jschmidtcr/manoRobot/archivos de mano 3D/README

Archivos obtenidos de http://www.inmoov.fr/download/
