jschmidtcr/manoRobot/archivos de mano 3D/Hand_robot__InMoov/WristlargeV4.stl

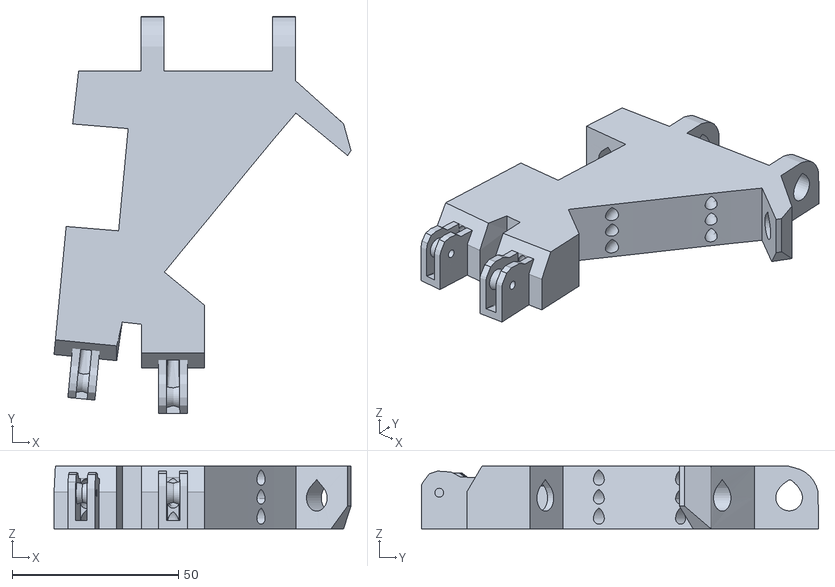
[picture p10: CAD file, 2014-05-28]
archivos de mano 3D/Hand_robot__InMoov/WristlargeV4.stl
89.2 x 119.4 x 18.9
