jschmidtcr/manoRobot/archivos de mano 3D/Inmoov_Robot_Rotation_Wrist/rotawrist2.stl

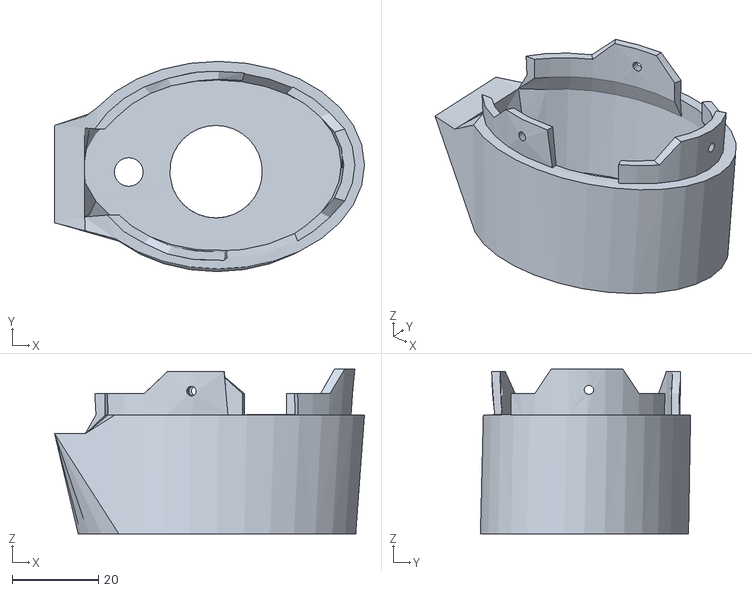
[picture p11: CAD file, 2014-05-28]
archivos de mano 3D/Inmoov_Robot_Rotation_Wrist/rotawrist2.stl
72.1 x 48.9 x 38.3
