jschmidtcr/manoRobot/archivos de mano 3D/Hand_robot__InMoov/robpart2V3.stl

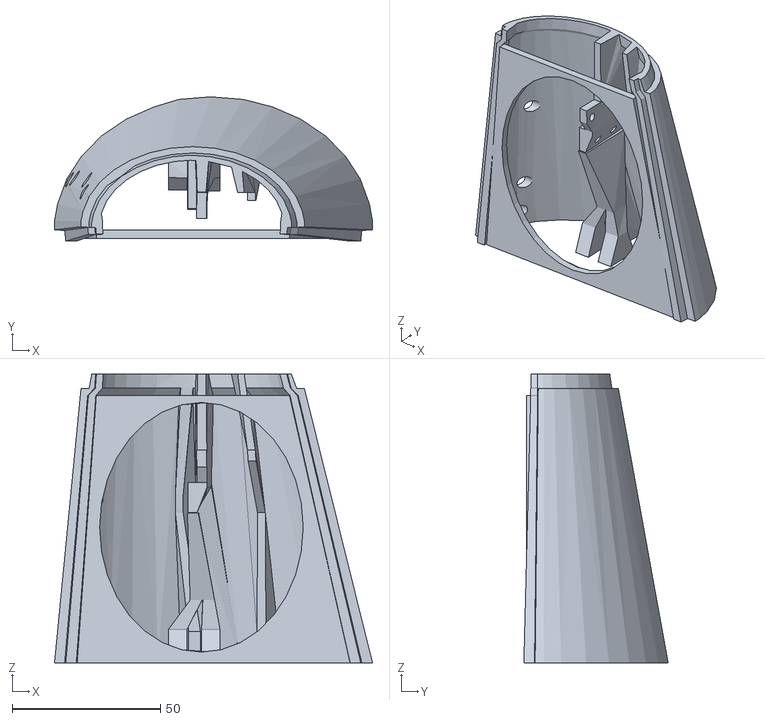
[picture p12: CAD file, 2014-05-28]
archivos de mano 3D/Hand_robot__InMoov/robpart2V3.stl
107.2 x 48.7 x 97.3
