jschmidtcr/manoRobot/archivos de mano 3D/Hand_robot__InMoov/topsurface4.stl

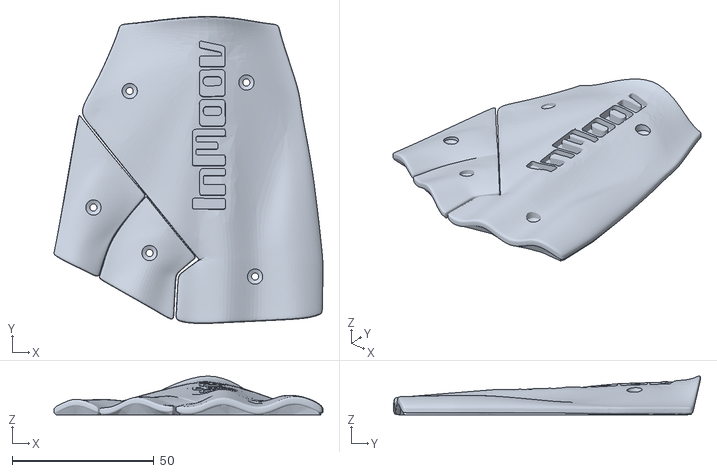
[picture p13: CAD file, 2014-05-28]
archivos de mano 3D/Hand_robot__InMoov/topsurface4.stl
94.9 x 108.3 x 13.7
