jschmidtcr/manoRobot/archivos de mano 3D/Inmoov_Robot_Rotation_Wrist/cableholderwristV4.stl

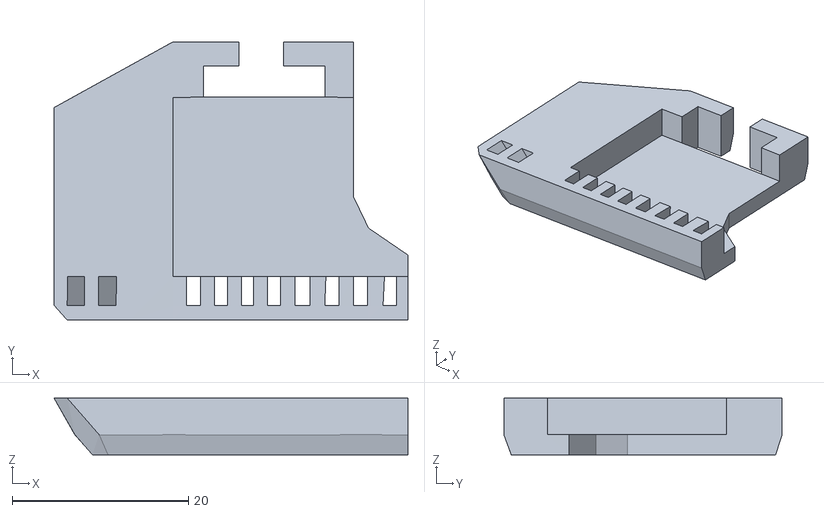
[picture p14: CAD file, 2014-05-28]
archivos de mano 3D/Inmoov_Robot_Rotation_Wrist/cableholderwristV4.stl
40.2 x 31.6 x 6.44
