jschmidtcr/manoRobot/archivos de mano 3D/Hand_robot__InMoov/ardiuinosupport.stl

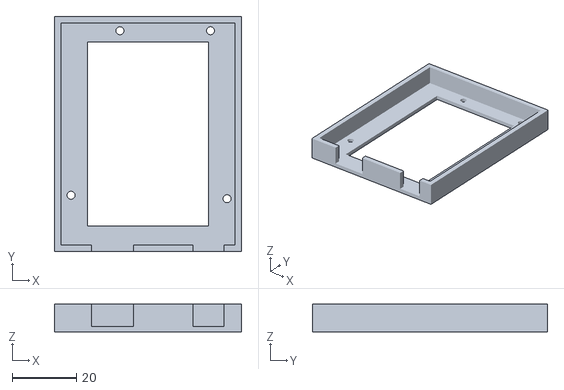
[picture p15: CAD file, 2014-05-28]
archivos de mano 3D/Hand_robot__InMoov/ardiuinosupport.stl
58.0 x 73.0 x 8.62
