jschmidtcr/manoRobot/archivos de mano 3D/Inmoov_Robot_Rotation_Wrist/rotawrist1V3.stl

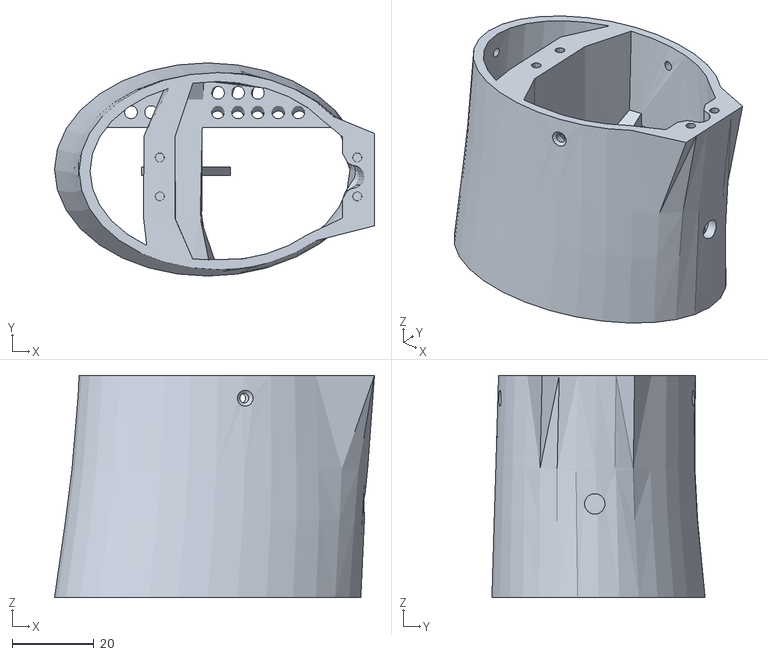
[picture p16: CAD file, 2014-05-28]
archivos de mano 3D/Inmoov_Robot_Rotation_Wrist/rotawrist1V3.stl
78.4 x 52.2 x 54.4
