jschmidtcr/manoRobot/archivos de mano 3D/Hand_robot__InMoov/robpart3V3.stl

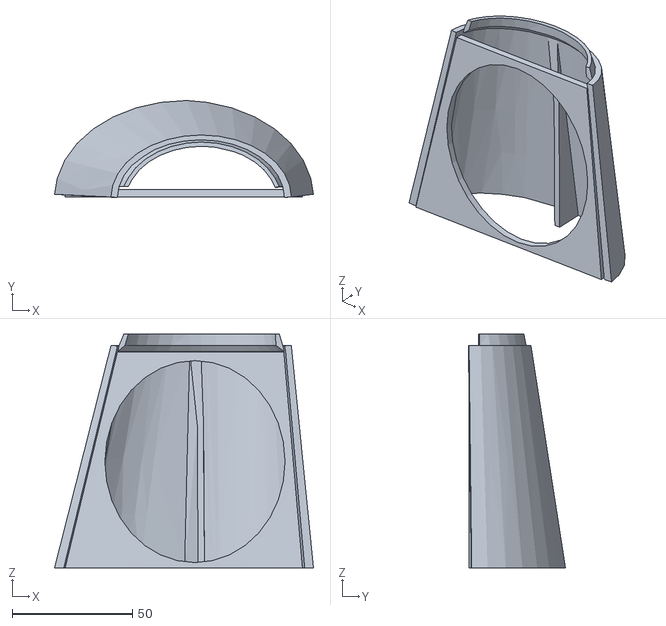
[picture p17: CAD file, 2014-05-28]
archivos de mano 3D/Hand_robot__InMoov/robpart3V3.stl
107.8 x 40.4 x 97.3
