jschmidtcr/manoRobot/archivos de mano 3D/Inmoov_Robot_Rotation_Wrist/rotawrist3V2.stl

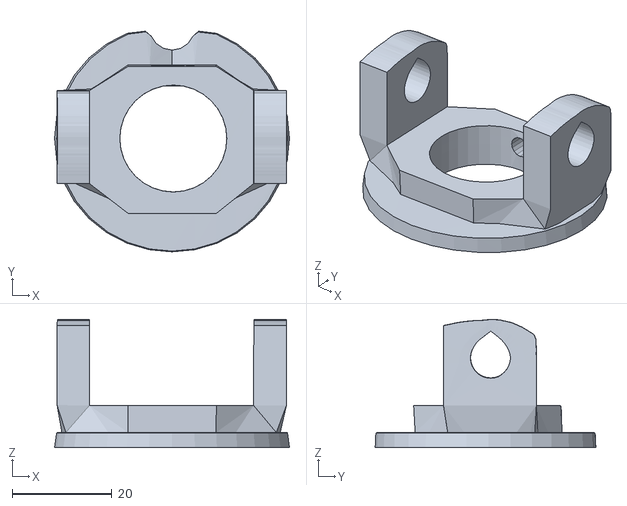
[picture p18: CAD file, 2014-05-28]
archivos de mano 3D/Inmoov_Robot_Rotation_Wrist/rotawrist3V2.stl
47.2 x 44.3 x 25.7
