jschmidtcr/manoRobot/archivos de mano 3D/Hand_robot__InMoov/ringfinger3.stl

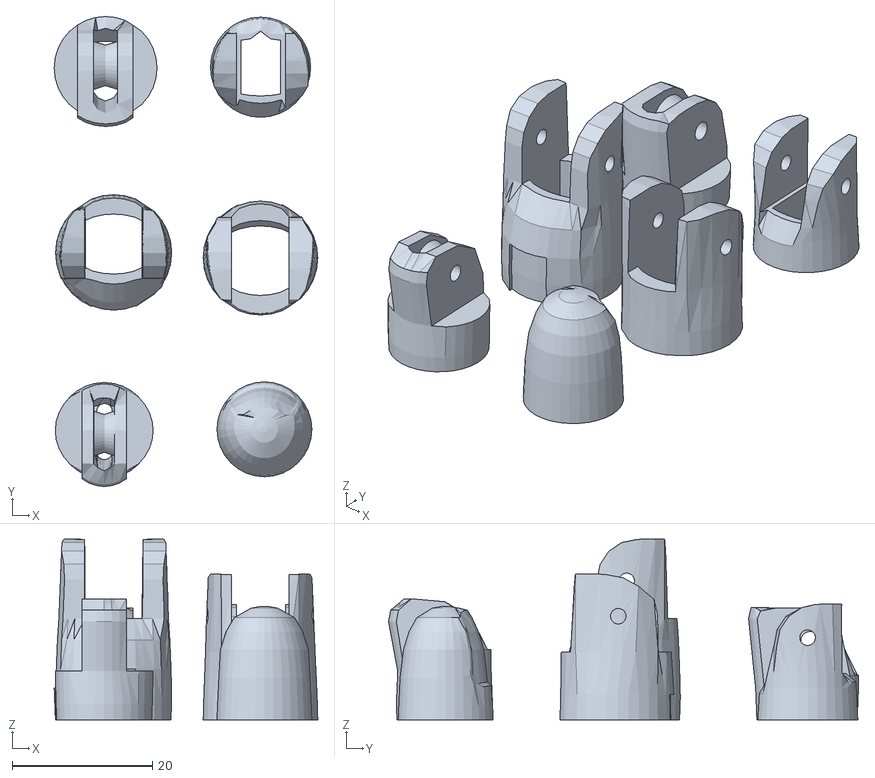
[picture p19: CAD file, 2014-05-28]
archivos de mano 3D/Hand_robot__InMoov/ringfinger3.stl
37.6 x 67.0 x 25.8
