jschmidtcr/manoRobot/archivos de mano 3D/Inmoov_Robot_Rotation_Wrist/WristGearsV4.stl

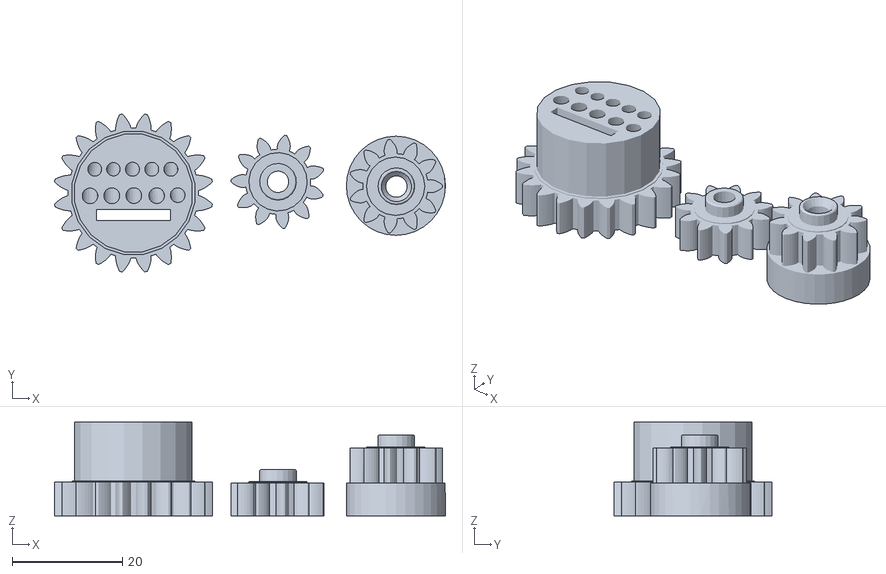
[picture p20: CAD file, 2014-05-28]
archivos de mano 3D/Inmoov_Robot_Rotation_Wrist/WristGearsV4.stl
71.0 x 28.7 x 17.1
