jschmidtcr/manoRobot/archivos de mano 3D/Hand_robot__InMoov/coverfinger1.stl

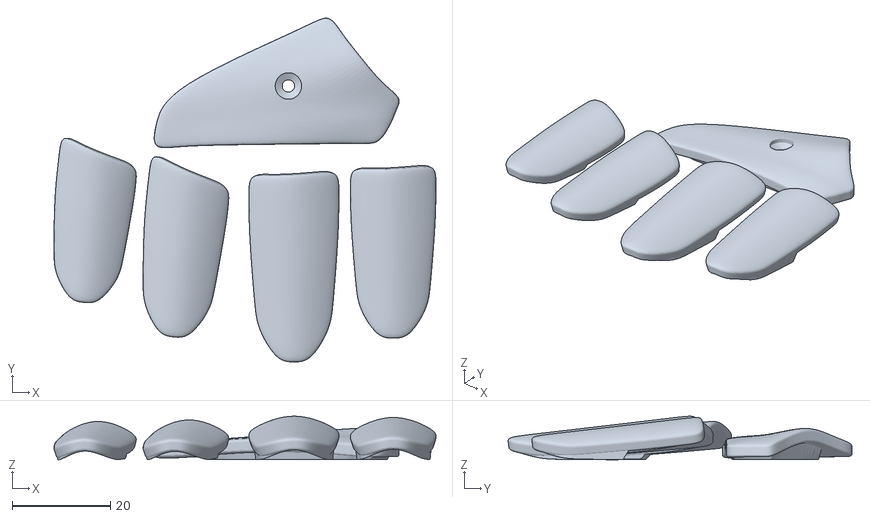
[picture p21: CAD file, 2014-05-28]
archivos de mano 3D/Hand_robot__InMoov/coverfinger1.stl
77.7 x 69.9 x 8.87
