jschmidtcr/manoRobot/archivos de mano 3D/Hand_robot__InMoov/robpart5V3.stl

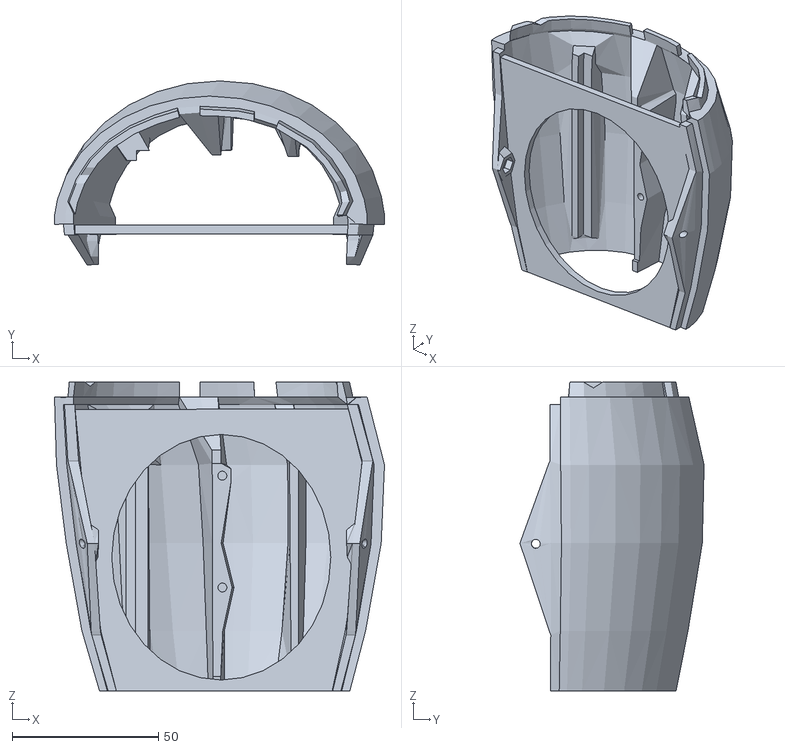
[picture p22: CAD file, 2014-05-28]
archivos de mano 3D/Hand_robot__InMoov/robpart5V3.stl
113.0 x 63.1 x 105.7
