jschmidtcr/manoRobot/archivos de mano 3D/Hand_robot__InMoov/Auriculaire3.stl

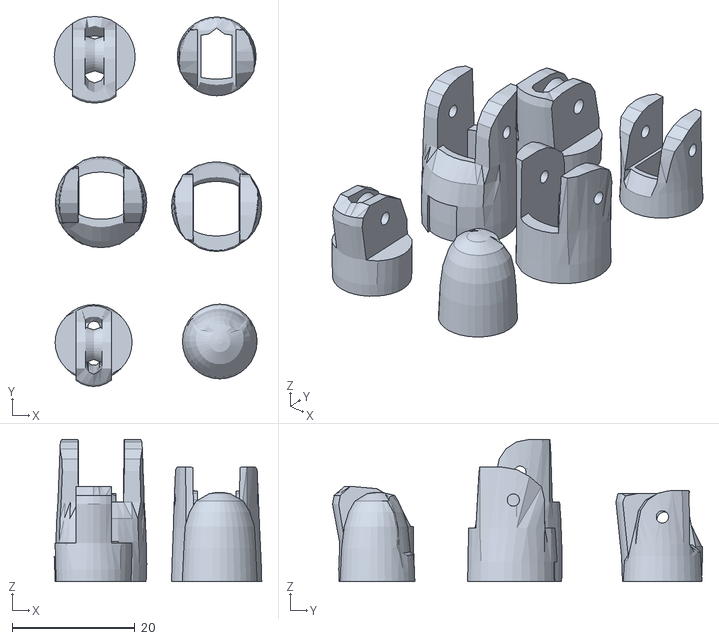
[picture p23: CAD file, 2014-05-28]
archivos de mano 3D/Hand_robot__InMoov/Auriculaire3.stl
33.8 x 60.3 x 23.2
