jschmidtcr/manoRobot/archivos de mano 3D/Hand_robot__InMoov/Index3.stl

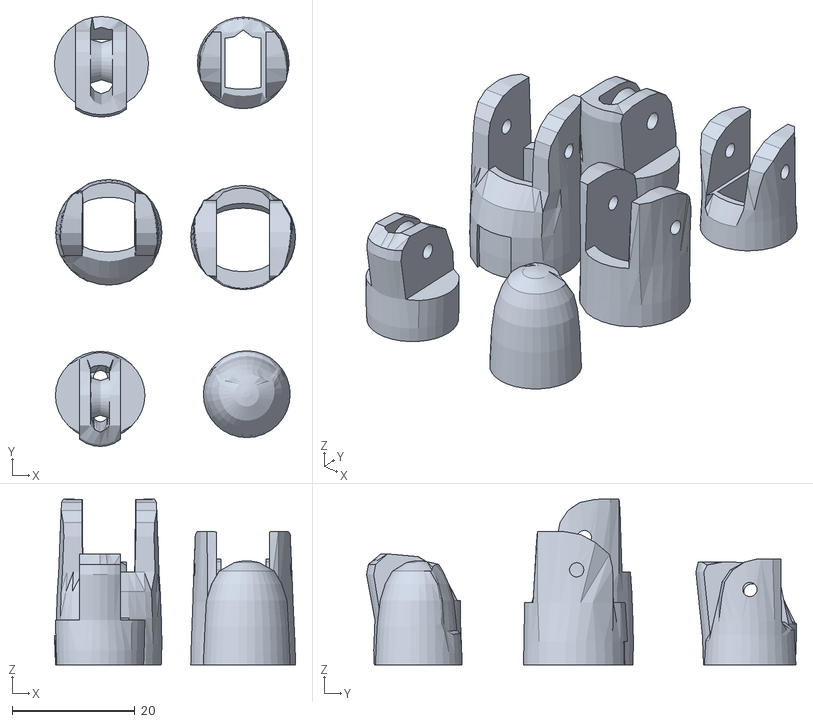
[picture p24: CAD file, 2014-05-28]
archivos de mano 3D/Hand_robot__InMoov/Index3.stl
39.4 x 70.2 x 27.0
