jschmidtcr/manoRobot/archivos de mano 3D/Hand_robot__InMoov/Majeure3.stl

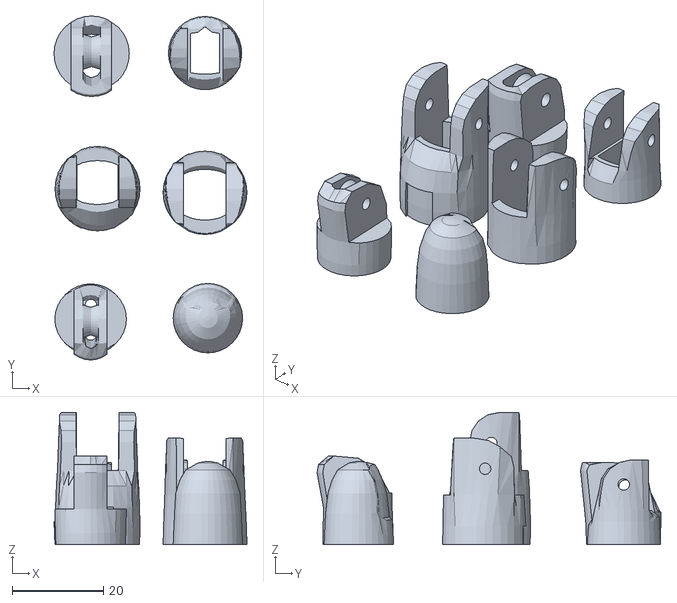
[picture p25: CAD file, 2014-05-28]
archivos de mano 3D/Hand_robot__InMoov/Majeure3.stl
42.2 x 75.2 x 29.0
