jschmidtcr/manoRobot/archivos de mano 3D/Hand_robot__InMoov/WristsmallV3.stl

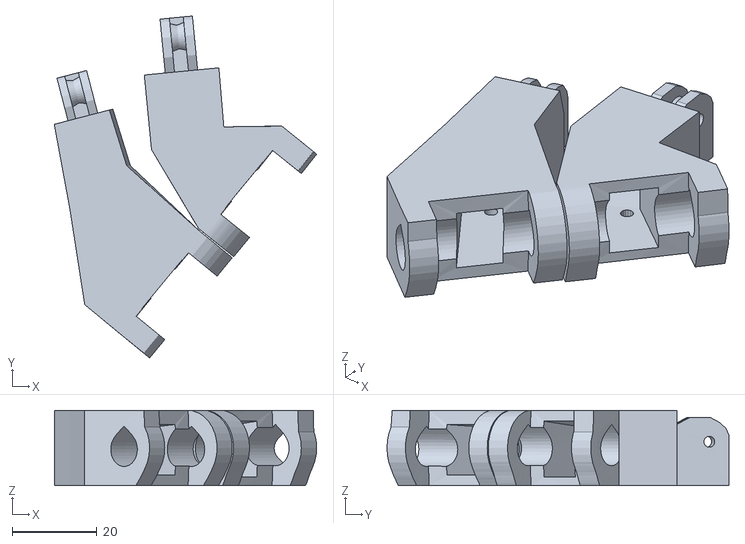
[picture p26: CAD file, 2014-05-28]
archivos de mano 3D/Hand_robot__InMoov/WristsmallV3.stl
62.0 x 80.8 x 17.7
