jschmidtcr/manoRobot/archivos de mano 3D/Hand_robot__InMoov/robcap3V1.stl

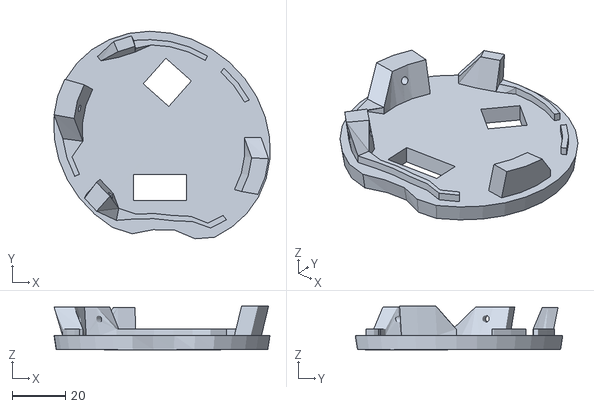
[picture p27: CAD file, 2014-05-28]
archivos de mano 3D/Hand_robot__InMoov/robcap3V1.stl
81.4 x 78.2 x 16.4
