jschmidtcr/manoRobot/archivos de mano 3D/Hand_robot__InMoov/thumb5.stl

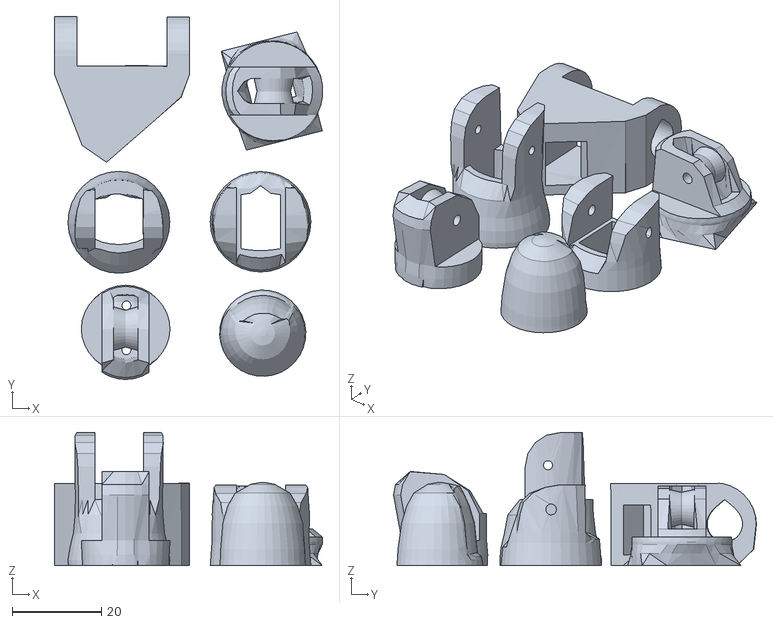
[picture p28: CAD file, 2014-05-28]
archivos de mano 3D/Hand_robot__InMoov/thumb5.stl
60.1 x 81.2 x 29.8
