jschmidtcr/manoRobot/archivos de mano 3D/Hand_robot__InMoov/robpart4V3.stl

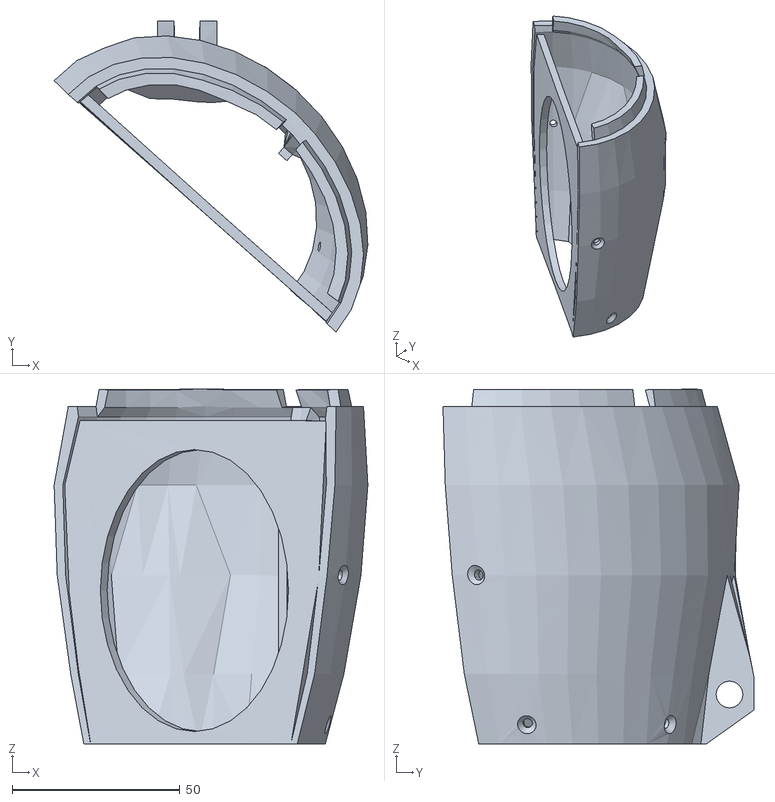
[picture p29: CAD file, 2014-05-28]
archivos de mano 3D/Hand_robot__InMoov/robpart4V3.stl
93.5 x 92.7 x 105.8
