jschmidtcr/manoRobot/(list of files, cad)

Other CAD files:
archivos de mano 3D/Inmoov_Robot_Rotation_Wrist/leftrotawrist2.stl
archivos de mano 3D/Inmoov_Robot_Rotation_Wrist/Leftrotawrist1V3.stl
archivos de mano 3D/Inmoov_Robot_Rotation_Wrist/LeftCableHolderWristV4.stl
archivos de mano 3D/Hand_robot__InMoov/Bolt_entretoise6.stl
