jschmidtcr/manoRobot/(commit log)

2014-03-31 control de leap y comunicacion serial, no conectados
2014-03-31 conectado el dedo indice con el arduino
2014-05-06 agregado soporte para windows
2014-05-13 agregado control con emotiv para windows
2014-05-27 correccion de manual
2014-05-28 agregados archivos y documentacion sobre mano 3D
    [Auriculaire3.stl, Bolt_entretoise6.stl, Index3.stl, LeftCableHolderWristV4.stl, Leftrotawrist1V3.stl, Majeure3.stl, WristGearsV4.stl, WristlargeV4.stl]
